ethan-se/pipettino-casa0014/concept/concept-sketch-1.jpeg

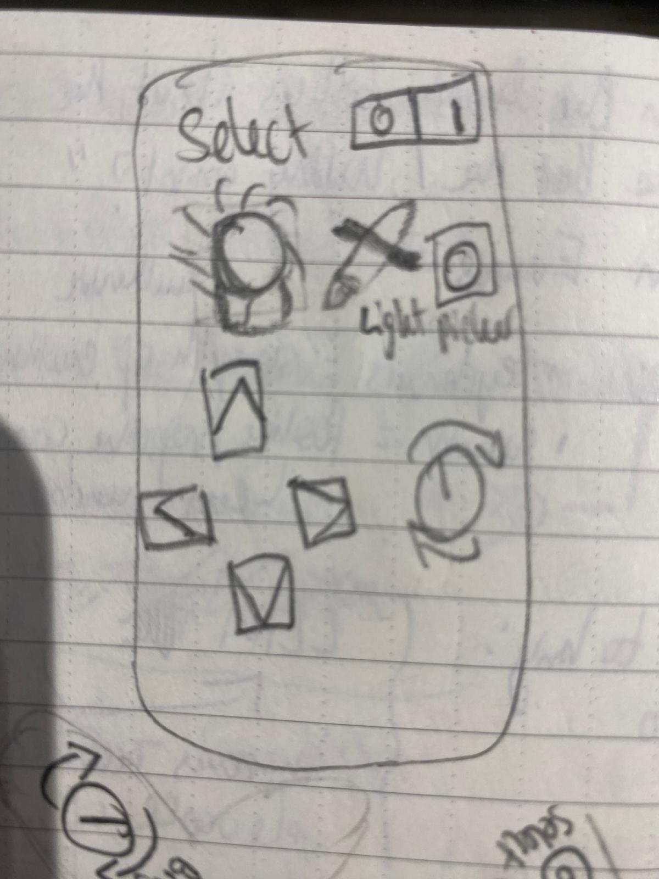
concept/concept-sketch-1.jpeg
