ethan-se/pipettino-casa0014/concept/concept-sketch-2.jpeg

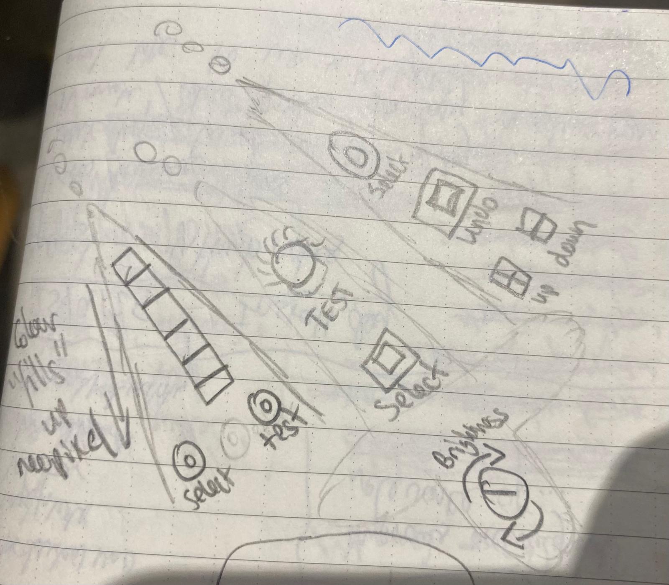
concept/concept-sketch-2.jpeg
