ethan-se/pipettino-casa0014/concept/concept-sketch-3.jpeg

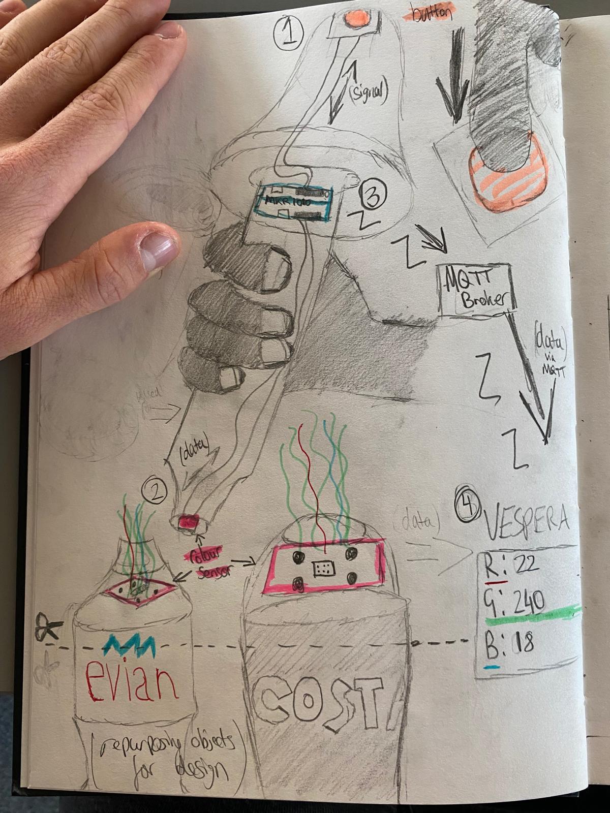
concept/concept-sketch-3.jpeg
