ethan-se/pipettino-casa0014/concept/final-build-1.jpeg

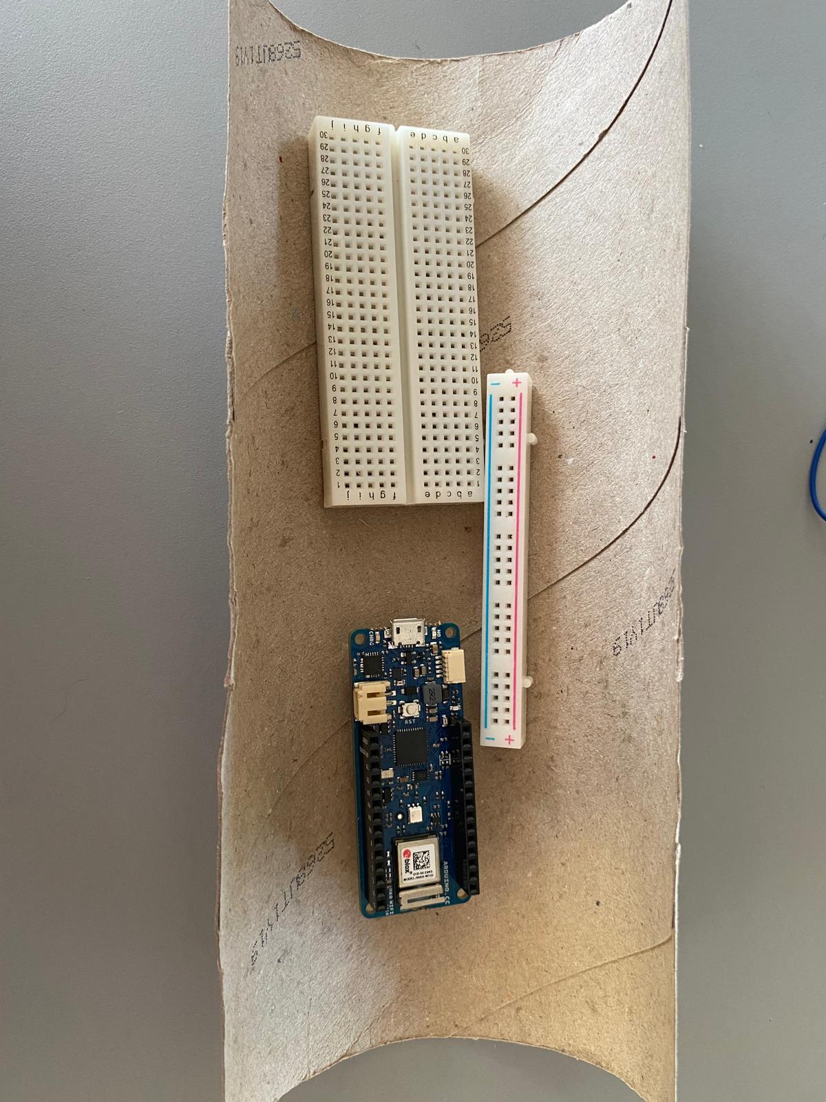
concept/final-build-1.jpeg
