ethan-se/pipettino-casa0014/concept/final-build-2.jpeg

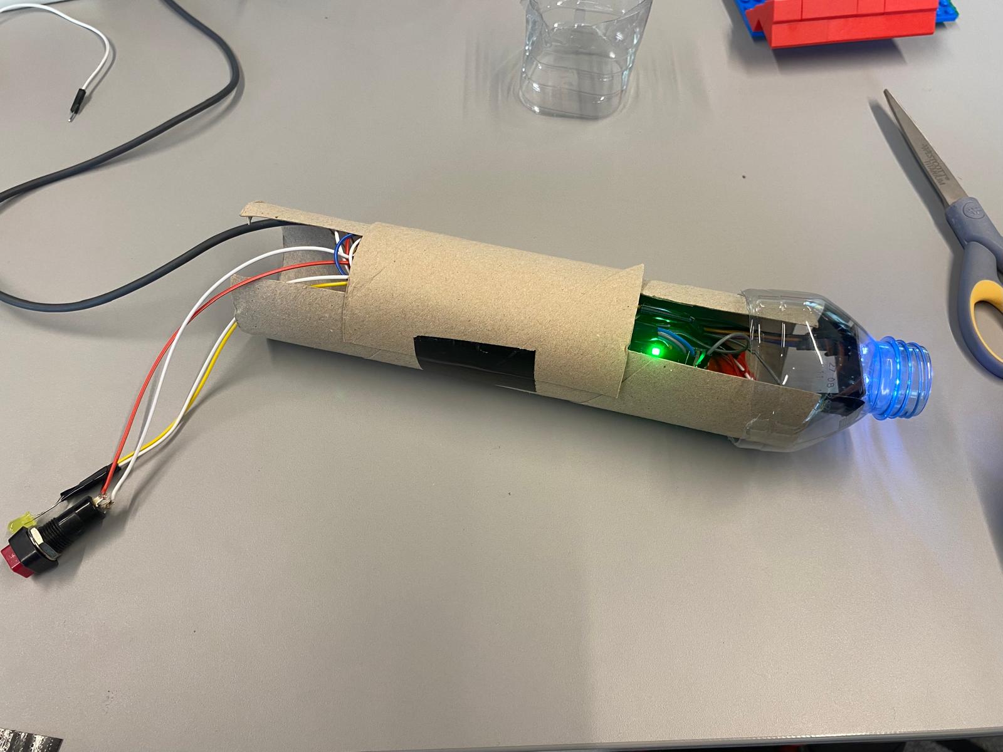
concept/final-build-2.jpeg
