ethan-se/pipettino-casa0014/concept/final-build-3.jpeg

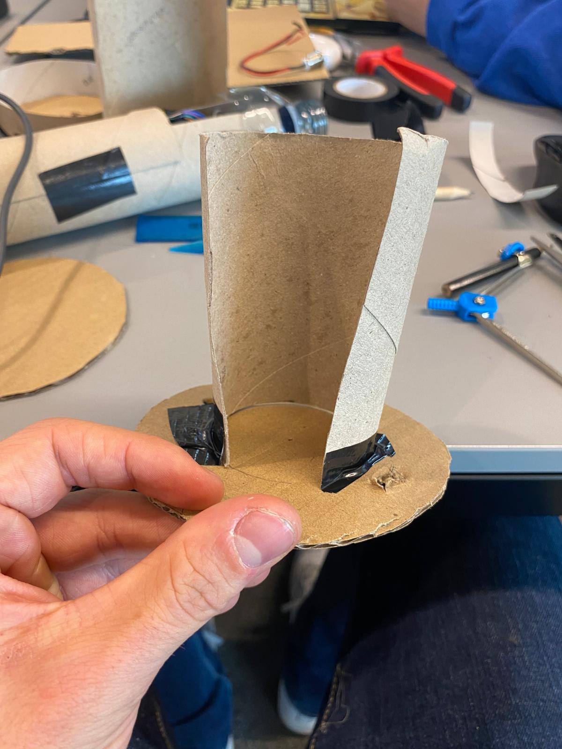
concept/final-build-3.jpeg
