ethan-se/pipettino-casa0014/concept/final-build-4.jpeg

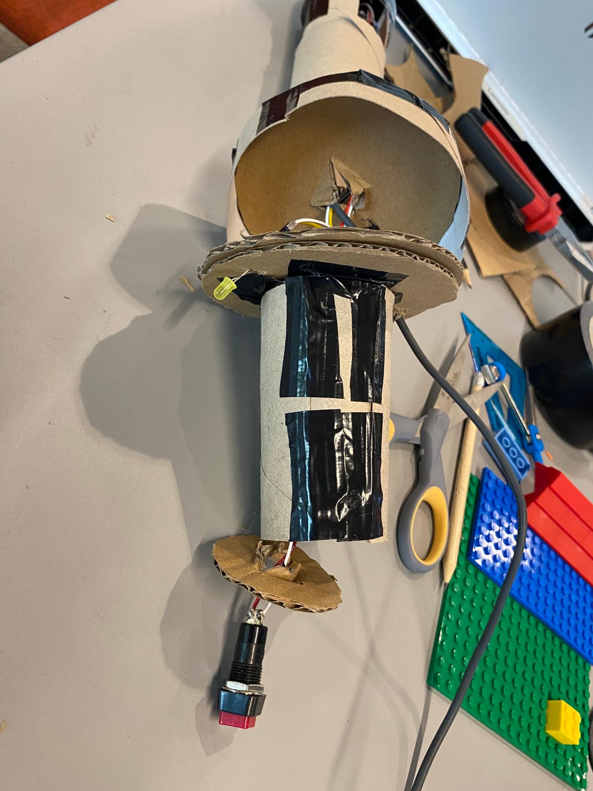
concept/final-build-4.jpeg
