ethan-se/pipettino-casa0014/concept/final-build-5.jpeg

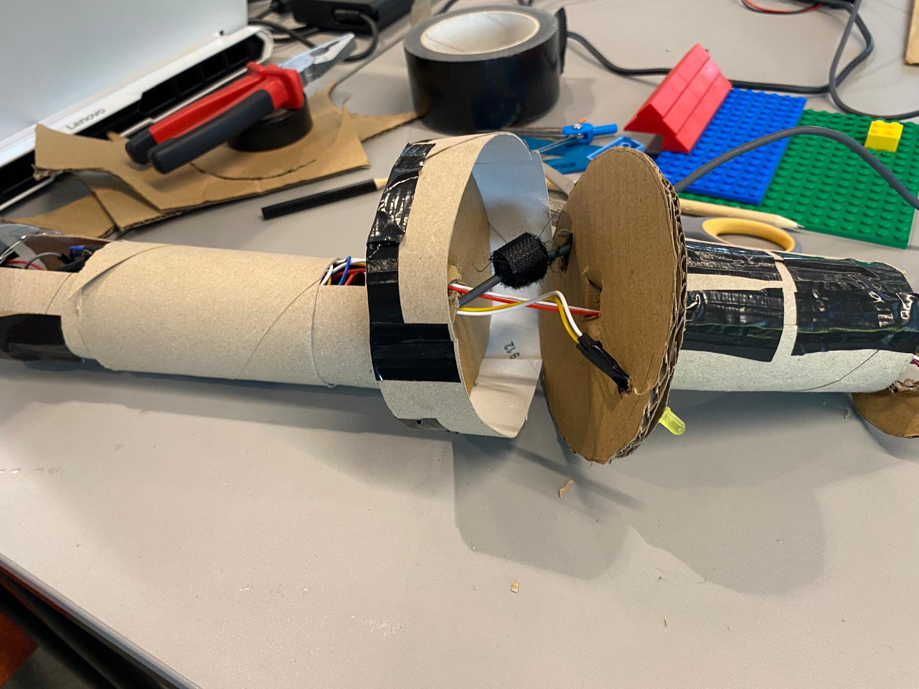
concept/final-build-5.jpeg
