ethan-se/pipettino-casa0014/concept/final-build-6.jpeg

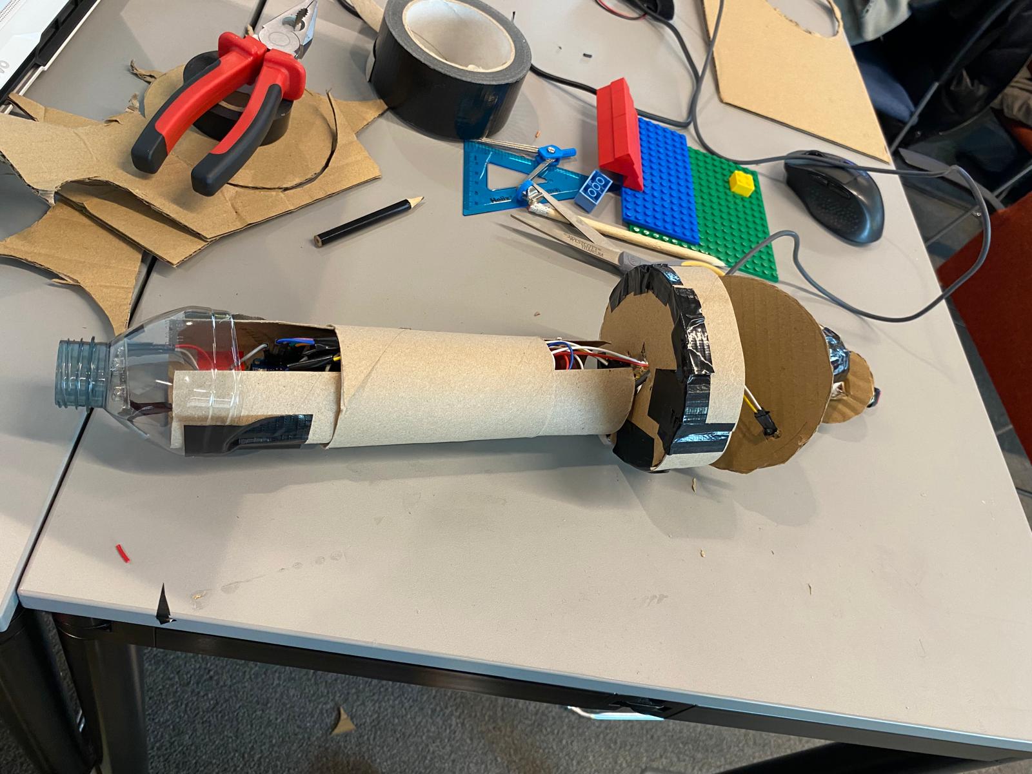
concept/final-build-6.jpeg
