ethan-se/pipettino-casa0014/concept/test-build-1.jpeg

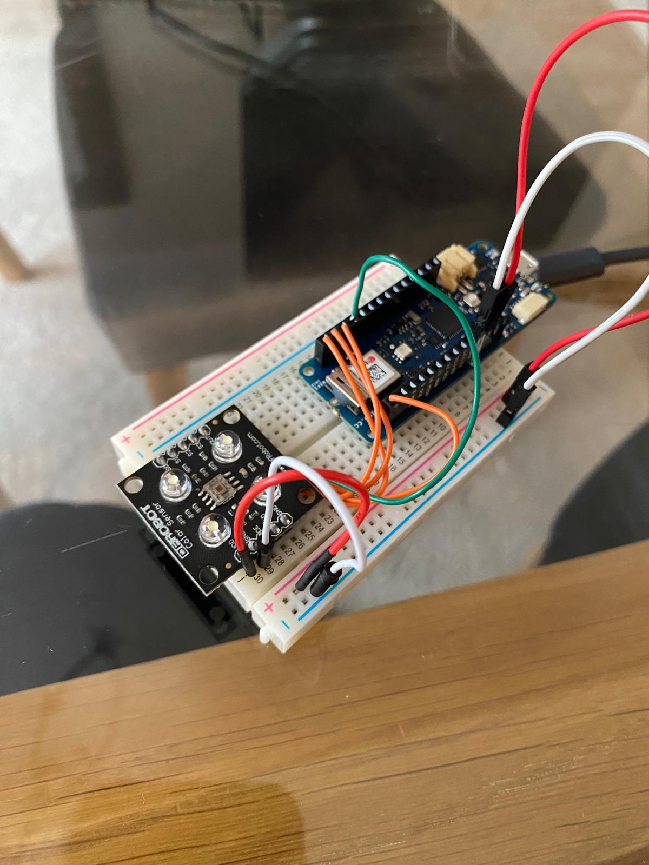
concept/test-build-1.jpeg
