ethan-se/pipettino-casa0014/concept/test-build-2.jpeg

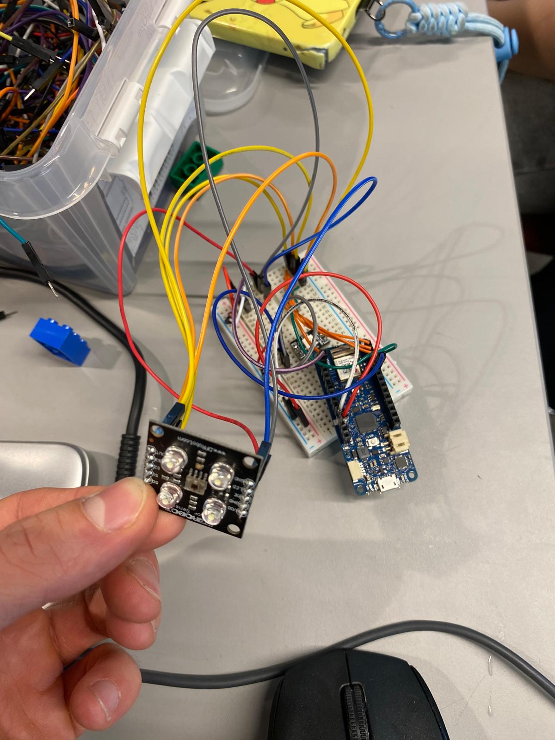
concept/test-build-2.jpeg
