ethan-se/pipettino-casa0014/concept/test-build-3.jpeg

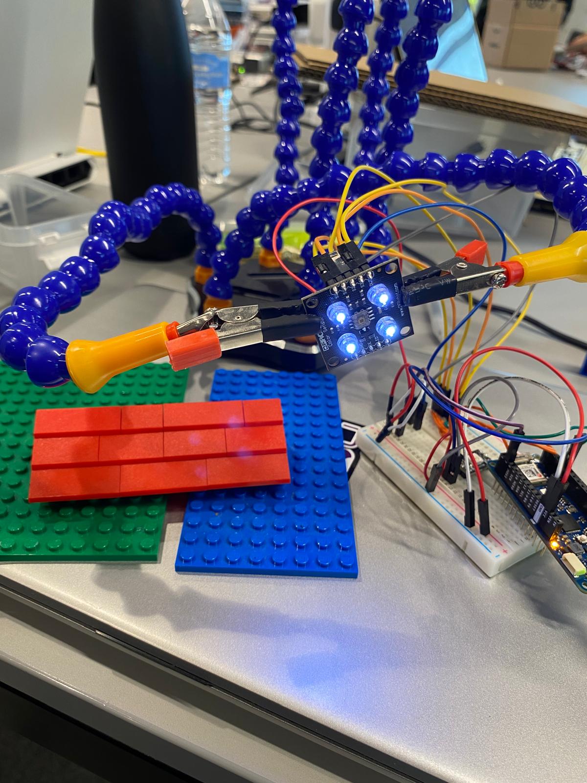
concept/test-build-3.jpeg
