ethan-se/pipettino-casa0014/concept/test-build-4.jpeg

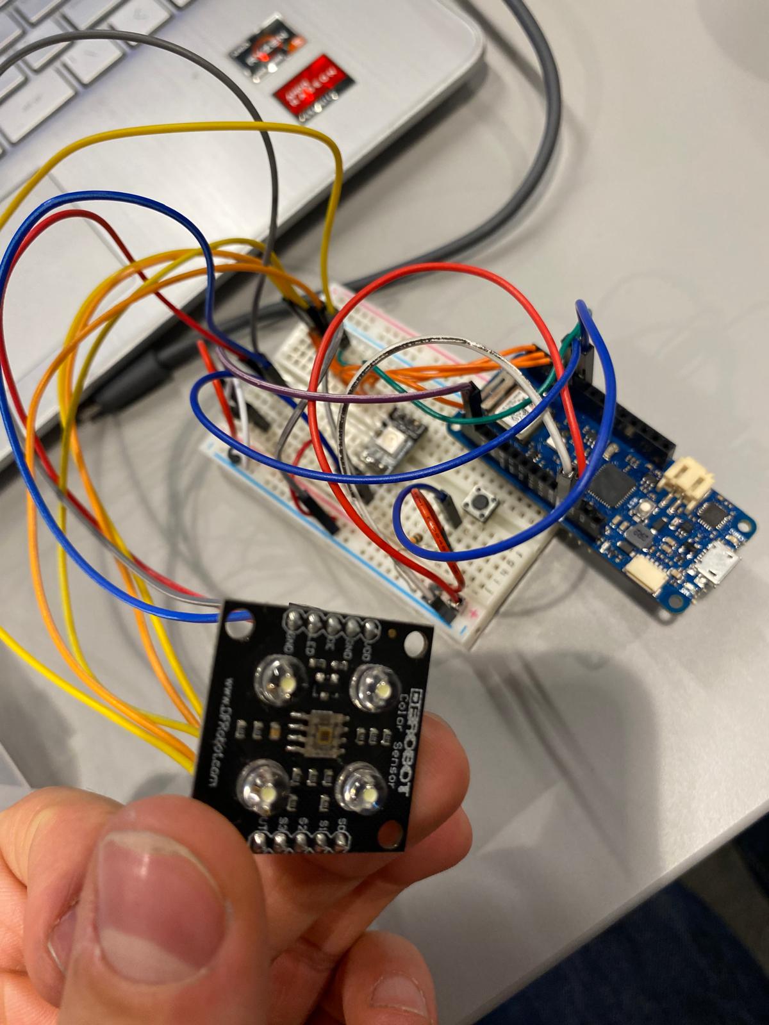
concept/test-build-4.jpeg
