ethan-se/pipettino-casa0014/concept/test-build-5.jpeg

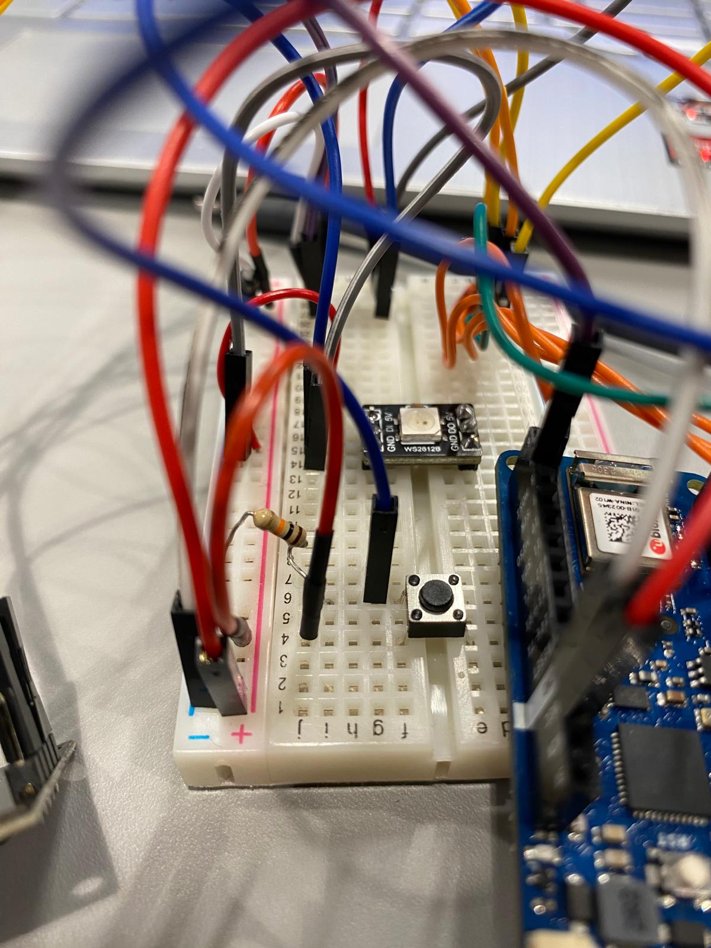
concept/test-build-5.jpeg
