ethan-se/pipettino-casa0014/src/workshop-mqttPublish.ino

// Function to update the R, G, B values of a single LED pixel
// RGB can a value between 0-254, pixel is 0-71 for a 72 neopixel strip
void send_RGB_to_pixel(int r, int g, int b, int pixel) {
  // Check if the mqttClient is connected before publishing
  if (mqttClient.connected()) {
    // Update the byte array with the specified RGB color pattern
    RGBpayload[pixel * 3 + 0] = (byte)r; // Red
    RGBpayload[pixel * 3 + 1] = (byte)g; // Green
    RGBpayload[pixel * 3 + 2] = (byte)b; // Blue

    // Publish the byte array
    mqttClient.publish(mqtt_topic.c_str(), RGBpayload, payload_size);
    
    // Serial.println("Published whole byte array after updating a single pixel.");
  } else {
    Serial.println("MQTT mqttClient not connected, cannot publish from *send_RGB_to_pixel*.");
  }
}

void send_all_off() {
  // Check if the mqttClient is connected before publishing
  if (mqttClient.connected()) {
    // Fill the byte array with the specified RGB color pattern
    for(int pixel=0; pixel < num_leds; pixel++){
      RGBpayload[pixel * 3 + 0] = (byte)0; // Red
      RGBpayload[pixel * 3 + 1] = (byte)0; // Green
      RGBpayload[pixel * 3 + 2] = (byte)0; // Blue
    }
    // Publish the byte array
    mqttClient.publish(mqtt_topic.c_str(), RGBpayload, payload_size);
    
    Serial.println("Published an all zero (off) byte array.");
  } else {
    Serial.println("MQTT mqttClient not connected, cannot publish from *send_all_off*.");
  }
}

void send_all_random() {
  // Check if the mqttClient is connected before publishing
  if (mqttClient.connected()) {
    // Fill the byte array with the specified RGB color pattern
    for(int pixel=0; pixel < num_leds; pixel++){
      RGBpayload[pixel * 3 + 0] = (byte)random(50,256); // Red - 256 is exclusive, so it goes up to 255
      RGBpayload[pixel * 3 + 1] = (byte)random(50,256); // Green
      RGBpayload[pixel * 3 + 2] = (byte)random(50,256); // Blue
    }
    // Publish the byte array
    mqttClient.publish(mqtt_topic.c_str(), RGBpayload, payload_size);
    
    Serial.println("Published an all random byte array.");
  } else {
    Serial.println("MQTT mqttClient not connected, cannot publish from *send_all_random*.");
  }
}
