ethan-se/pipettino-casa0014/(commit log)

2025-10-18 feat: create test script for TCS3200 colour sensor
    So far I have one test script that outputs RGB values read by
    the sensor to the serial monitor. I'm having trouble understanding
    at a glance whether the sensor is picking up the right colours.
    Todo: create second test script that outputs value to an RGB LED,
    like a neopixel.
2025-10-18 feat: new test script that outputs to NeoPixel
    Problem: the colour displayed on the neopixel is the inverse to the
    colour detected.
    This is because what is measured is the duration of the
    pulse using pulseIn(). An object reflects its own colour into the sensor
    at a much higher frequency than other colours in the light spectrum.
    Since the duration of a signal is 1/frequency, lower values read by
    the sensor actually mean a higher intensity of colour is being read.
    Todo: Find a way to translate colour readings into a useful format
    for the NeoPixel LEDs to display accurate colours.
    [tcs3200-test-neopixel.ino]
2025-10-20 feat: create test script to send data to Vespera
    Initial colour calibration and remapping successful. Colours display
    to Luminaire Colour Grid with reasonable, but not great, accuracy.
    Todo: tweak frequency value remapping for improved colour accuracy.
2025-10-20 feat: create button test scripts
2025-10-20 feat: add code for main device functionality
    Pieced together from all test scripts written so far, as well as the
    example MQTT connection code from the casa0014 GitHub repository.
    Appears to function as expected, bar colour inaccuracies.
    Todo: recalibrate sensor values for more accurate colours, add debug
    code to fix integer overflow from anomalous readings.
    Potentially: add custom animation to lights, get them to "fill up"
    with colour from the bottom up
2025-10-22 feat: add "busy" LED functionality to device
    It turns on during MQTT initial connection,
    reconnection attempts, and sending payloads.
    Also rewired pins - this is reassigned in the
    src code. Currently not reflected in test scripts.
2025-10-25 fix: Match pin for button test with pin in src
    [buttonResistor-test-SerialMonitor.ino]
2025-10-27 fix: make tactile button act like linear button
    [src.ino]
2025-10-27 fix: reduce serial monitor verbosity
    [workshop-connections.ino]
2025-10-29 feat: add circuit diagram to readme.md
